SJSURoboticsTeam/URC-Mechanical-2023/ESPCAM/BP-70A BATTERY.step

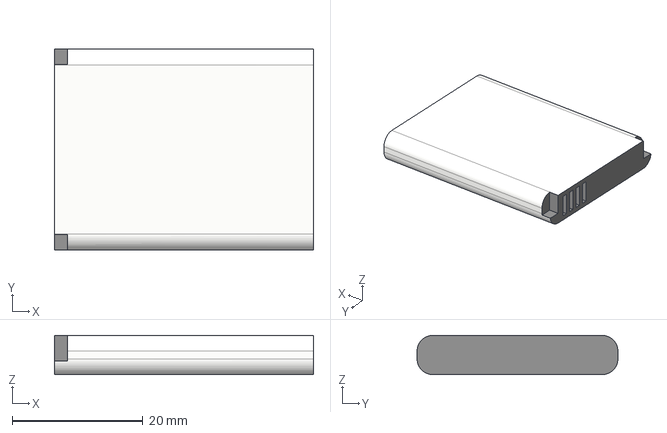
[picture p1: CAD file, 2023-09-21]
ESPCAM/BP-70A BATTERY.step
39.6 x 30.7 x 5.99 mm
