SJSURoboticsTeam/URC-Mechanical-2023/ESPCAM/CONN-SMD_BC-12-4P.step

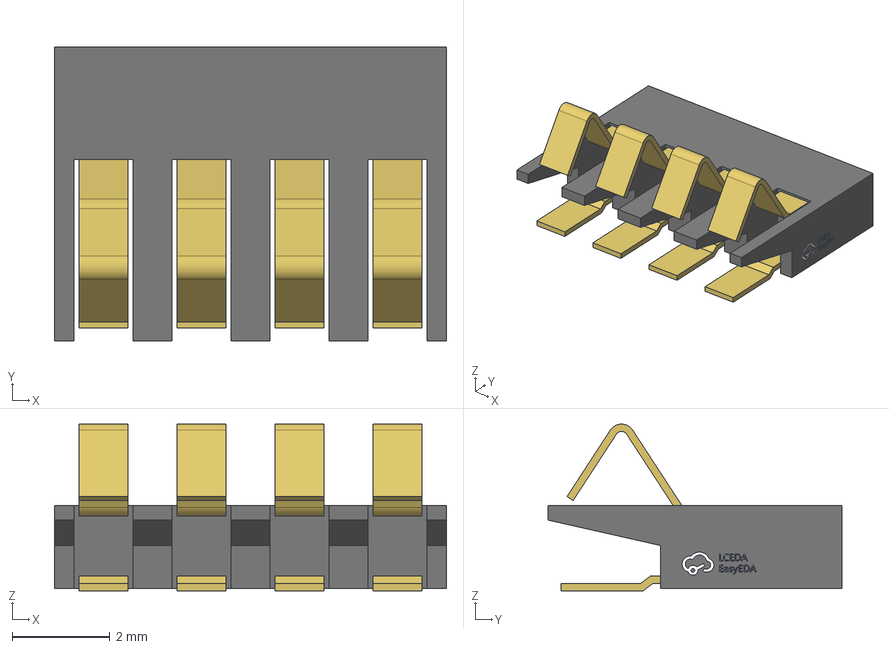
[picture p2: CAD file, 2023-09-21]
ESPCAM/CONN-SMD_BC-12-4P.step
8.00 x 6.00 x 3.40 mm
