SJSURoboticsTeam/URC-Mechanical-2023/ESPCAM/ESPCAM ASSEMBLY.pdf

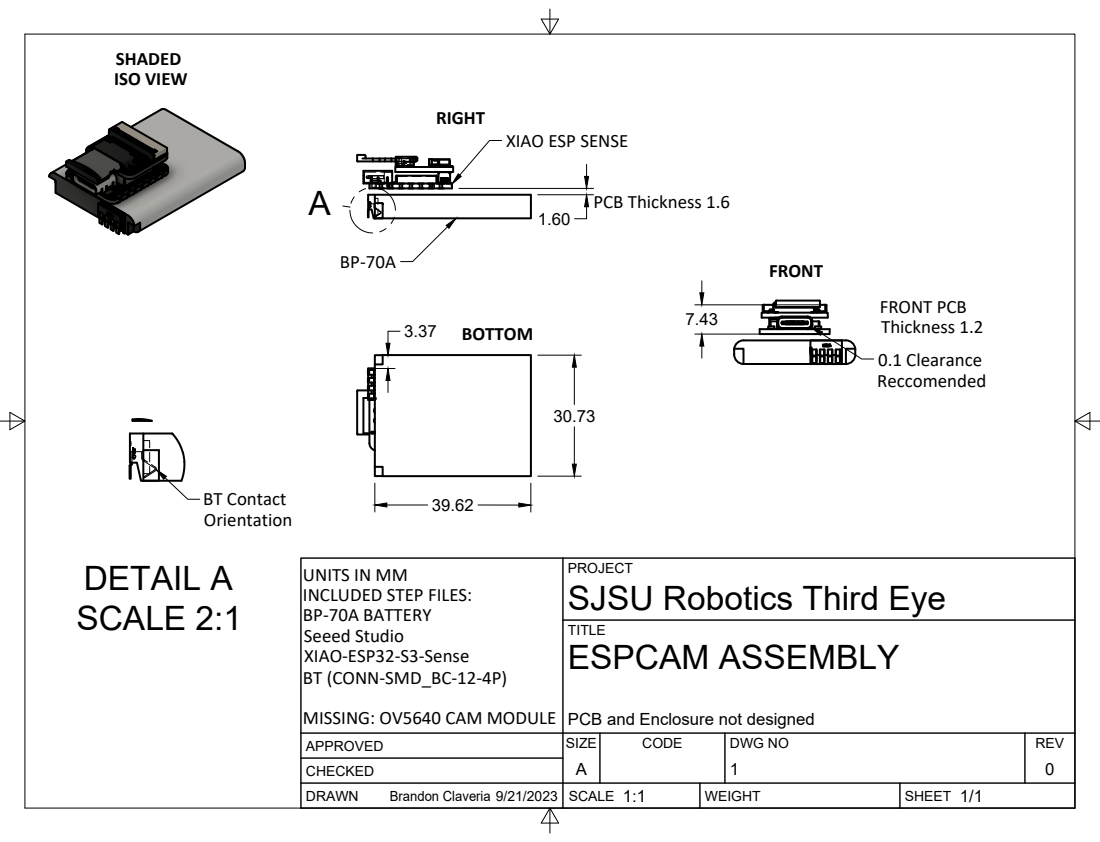
[picture p3: page 1]
SIZE; CODE; DWG NO; REV; Brandon Claveria 9/21/2023; PCB Thickness 1.6; DETAIL A SCALE 2:1; BT Contact; FRONT PCB Thickness 1.2; 0.1 Clearance; ISO VIEW

XIAO ESP SENSE

UNITS IN MM
INCLUDED STEP FILES:
BP-70A BATTERY
Seeed Studio
XIAO-ESP32-S3-Sense
BT (CONN-SMD_BC-12-4P)

PROJECT
SJSU Robotics Third Eye
ESPCAM ASSEMBLY

MISSING: OV5640 CAM MODULE

PCB and Enclosure not designed
