SJSURoboticsTeam/URC-Mechanical-2023/(threads)

Thread 1 (2022-11-20):

Fix Thin Walls

theblueone111, 2022-11-20:
Cad has thin walls from extrusion cuts. walls should be at least 1.5mm thick

Thread 2 (2022-11-20):

Shoulder Belt Tensioner

theblueone111, 2022-11-20:
The shoulder motor needs a belt tension implemented in Design

theblueone111, 2023-01-17:
Moved away from using a tension in favor of a larger pulley and new belt spacing

Closed 2023-01-17.

Thread 10 (2022-11-21):

Redesign Rotunda

theblueone111, 2022-11-21:
The rotunda no longer supports the mass thus needs a redesign. it will now only support arm electronics and battery and potentially a camera.

theblueone111, 2023-01-17:
there will be sort of a "backpack" that houses the universal board a camera, and the radio equipment

Closed 2023-04-20.

Thread 11 (2022-11-21):

Weight Robot

theblueone111, 2022-11-21:
the robot needs to be re-weighed to get new springs. after adding the arm and switching to the metal rotunda the robot is sitting a a lot lower, which is good but unexpected.

Closed 2023-01-17.

Thread 5 (2022-11-21):

Import All Pullies

theblueone111, 2022-11-21:
All pullies need to be imported from Solidworks into Onshape. This includes the arm and wheel pullies. Please import them into A Cad import folder within their respective Folder, AKA wheel pullies go in CAD imprt folder within Susp. folder.

Closed 2023-01-17.

Thread 6 (2022-11-21):

Design Slip ring assembly in Onshape

theblueone111, 2022-11-21:
the Slip ring assembly needs to be designed in onshape in the Steering Assembly PartSstudio

theblueone111, 2023-01-17:
i updated the onshape to sorta represent the real thing but we need to look it over all together to make sure its correct

Closed 2023-02-07.

Thread 7 (2022-11-21):

Design Battery Mount

theblueone111, 2022-11-21:
The mount for the ryobi 40v batteries needs to be designed, prototyped, manufactured, and tested

theblueone111, 2023-01-13:
make the battery retionion .5mm looser all around

theblueone111, 2023-01-18:
make sure the battery is removable and not not hit the suspension mount during removal

MayaEnriquez, 2023-01-24:
rotunda drive and arm battery mount have their own flat and angled versions now, drive battery clearance issue should be fixed, arm battery needs to be changed with comm tower

MayaEnriquez, 2023-02-02:
Angled mount has heat insert slots and Velcro channel, flat mount is not changed yet.

theblueone111, 2023-02-17:
purchased battery holder from amazon to expedite process as well due to lack of connector supplier

theblueone111, 2023-02-17:
battery mounts arriving feb 22 - 24

Closed 2023-07-04.

Thread 8 (2022-11-21):

Design Main Power Distribution Dorito Case

theblueone111, 2022-11-21:
The main Dorito PCB needs a case to be designed around it with 3D printing and PLA

theblueone111, 2023-01-11:
need to get updated model of the pcb as the one we currently used does not have the other two motor out connectors

theblueone111, 2023-01-12:
need tp update lid design to accommodate the usb out headers

MayaEnriquez, 2023-01-28:
waiting on new dorito design

MayaEnriquez, 2023-02-04:
new dorito design recieved, model made, not printed

MayaEnriquez, 2023-02-09:
printed

MayaEnriquez, 2023-02-25:
edits made for convenience, waiting on mounting schematic/plan to make mounting holes to be locked into place

MayaEnriquez, 2023-03-14:
Waiting on feedback/ Dorito changes were mentioned.

MayaEnriquez, 2023-04-20:
new dorito again

MayaEnriquez, 2023-07-04:
mounted to chassis bottom

Closed 2023-07-04.

Thread 15 (2023-01-09):

New motors all plates

theblueone111, 2023-01-09:
the new motor needs to be incorporated in the cad so that we can manufacture them asap

theblueone111, 2023-01-17:
new motors have been incorporated except for the rotunda

Closed 2023-01-24.

Thread 16 (2023-01-09):

Redesign arm

theblueone111, 2023-01-09:
arm needs to be way stiffer, including standoff/spacer mounts or full redesign

theblueone111, 2023-01-31:
updated outer links, need to update the lightening pattern and add hole pattern on mid links

theblueone111, 2023-03-14:
need to print all the arm plate spacers

MayaEnriquez, 2023-04-25:
Current To Do:
spacers /3d printed u channel? bearing sizes + belt tensioning

MayaEnriquez, 2023-05-07:
Currently Assembled for testing, future revision needs arm PCBs (hand Board + Bread-board + arm breakouts(3)) to have cases + wire management

PugslyFTW, 2023-10-09:
currently working on shrouds for pcbs to protect the pcbs from dust

Closed 2023-10-09.

Thread 17 (2023-01-09):

new motor backpacks

theblueone111, 2023-01-09:
the RMD X6 v2 S2 will have a pcb back pack to allow for USB -c interface. these pcbs need a spacer/enclosure designed to attach them to the tops of the motors

cdanderson4, 2023-02-03:
Motor backpacks completed, 4.8mm deep , 5.23mm diameter holes for m3 heated inserts. Brushes need to be ordered to glue in for dust prevention. Brushes: https://www.mcmaster.com/catalog/129/1551/7900T807

cdanderson4, 2023-02-03:
Still needs to be printed

MayaEnriquez, 2023-06-03:
Needs Redesign

Thread 18 (2023-01-09):

electronic Models

theblueone111, 2023-01-09:
all the electronics need to be modeled such that they can be arranged in the chassis

MayaEnriquez, 2023-01-24:
notes on what needs modeling:
Science: verify science dosing pump/vacuum pump
Comms Tower(Mission Control Bin):
Battery/mount
Transciever(Rocket 900?)
PoE connection
Access Point( after verification with mission control)
Comm Tower Case/ Wiring Setup

Closed 2023-01-18.

Thread 19 (2023-01-10):

Fix Steering assembly CAD

theblueone111, 2023-01-10:
the steering assembly part studio and assembly dont matc. the gap between the top and bottom plates are not the same from oen to the other

theblueone111, 2023-01-31:
the bottom steering plate needs to have its motor mounting holes fixed for the new s2 motors

theblueone111, 2023-01-31:
the belt spacing for the drive motors needs to be fixed to allow for the new 30T pulleys

Closed 2023-04-11.

Thread 20 (2023-01-17):

Manufacture all new plates for new motors and redesigns

theblueone111, 2023-01-17:
need to manufacture all the new plates

theblueone111, 2023-01-17:
new plates cant be made until all design changes are confirmed

theblueone111, 2023-01-17:
arm is gunna be nade to work with new motors for this version but still be redesigned for after the video

theblueone111, 2023-02-01:
all parts sent to ISM. waiting on response

theblueone111, 2023-02-03:
Talked with ims manager and he received the parts. the last set were waterjet and i asked that they laser cut this set for better cut quality.

theblueone111, 2023-02-17:
1/8th arm plates arriving feb 18th everything else arriving feb 21-25

Closed 2023-03-14.

Thread 21 (2023-01-18):

Communications Backpack

theblueone111, 2023-01-18:
A coms "backpack" needs to be designed to houseall the radio equipment and the universal board for the arm. it must be elevated above the arm battery and be an enclosure

MayaEnriquez, 2023-01-24:
First Steps
Cad:
Battery/mount
Transciever(Rocket 900?)
PoE connection
Access Point( after verification with mission control)
Comm Tower Case/ Wiring Setup

MayaEnriquez, 2023-02-02:
Cad done on existing components, waiting on info if we will need new ordered parts, workable platform area marked in a cad file.

MayaEnriquez, 2023-03-14:
Cad updated to reflect new notes: 2voltage regulators(wait on electrical), battery, r900, trendnet, kmetech Poe,

MayaEnriquez, 2023-03-23:
3/23 update/to do/issues:
**rotunda**
Are we allowed to cover handle since comm tower screws on rotunda after?
Add comm tower mounting holes to arm and autonomy rotunda plates
Double check allowable overhang and arm clearance (real sits lower than cad)
Would mounting screws for items on comm tower also need to go through rotunda/ mounting plans

**autonomy specific**
LiDAR and camera FOV blocked by comm tower?
Two power supplies or not/extra voltage regulator needed?

**electrical**
Voltage regulator 12 v & 24 v, heat dissipation how?
Custom length cables/management?

**other**
Material of comm tower:
Metal + 3D printed?
Will Utah heat be an issue

kammce, 2023-03-24:
> Voltage regulator 12 v & 24 v, heat dissipation how?

It is unlikely that the voltage regulators will need any assistance in terms of heat dissipation. But if you choose to put it in a 3D printed plastic box without air holes in order to make it dust and water resistant, then there could be some issues with heat dissipation. But the current consumption of the M9 Rocket and the AP should be quite low.

MayaEnriquez, 2023-04-20:
trendnet is replaceable with tplink as tested by Gene, 2 versions of the comm tower, notes for second version are mixed in the Autonomy Setup Github notes

MayaEnriquez, 2023-04-25:
buck ready, permission to drill holes in plates for prototype.

MayaEnriquez, 2023-04-25:
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
R900 Mount leaning 20 degrees leaning back to avoid the arm, if interference continues with the arm, 45 degrees is the next test.

Power Buck ordered.

MayaEnriquez, 2023-05-04:
Tp Link Mount is roughly designed, the prototype has all the hardware, just waiting on the electrical. Second set still being looked into & wire management is not finalized. Currently no longer requires zip-ties, just 1 velcro.

MayaEnriquez, 2023-05-11:
Manufacturing Concepts:
1. Sheet Metal + risers(space for screws)
Strong in theory, sharp in practice
2. 3D Printed
Could work with ribbing + support, heat inserts & screws?
3. Cut acrylic/plastic sheet
Most accurate hole pattern? Also, heat inserts? Not clear
4. Holes Directly into the other rotunda plate
Screw heads would need to be countersunk properly and go up to avoid hitting I think. Con is the long manufacturing time.

MayaEnriquez, 2023-06-03:
camera mount on the pvc pipe that the r900 leans on, make it super long?

Thread 22 (2023-01-24):

Science Robot CAD NTD

theblueone111, 2023-01-24:
The CAD needs to be fully fleshed out.

tommytn54, 2023-02-11:
I Need to make funnel
Science PCB case

theblueone111, 2023-02-17:
magnets need to be designed into the revolver. the hall effects need to be located in the enclosure for the revolver positioning. all components need to be mounted to the enclosure and located

MayaEnriquez, 2023-02-25:
printed  latest version for SAR video, future reccomendation: science pcb not on the bottom of the case

MayaEnriquez, 2023-05-07:
magnets in gear, gear remesh, pcb reinstall, & pump install

MayaEnriquez, 2023-05-07:
gas sensor install into gas chamber? + remodel for pressure sensor https://www.sparkfun.com/products/19096

MayaEnriquez, 2023-05-09:
holes n zipties for pump on top

Closed 2023-10-14.

Thread 23 (2023-02-04):

Initial Science Robot Super Station Plunger CAD

kate-oxley, 2023-02-04:
The CAD for the super station's plunger mechanism needs to be completed

- [x] finalize the cam dimensions
- [x] create platform to push vial up
- [x] create the cam and related parts in onshape
- [x] review & begin redesign if needed

Closed 2023-02-07.

Thread 24 (2023-02-07):

Science Robot Final Plunger CAD

kate-oxley, 2023-02-07:
- [x] Redesign cam from pear shape to disk
- [x] Change cam follower from flat faced to roller
- [x] Design a way for the roller to attach (3D printed? bearing?)
- [x] Alter cam follower shaft to fit new parameters
- [x] Change mount from horizontal to vertical & merge pieced
- [x] Design top plate to be removable
- [x] Make plunger attach to super station
- [x] Create ~60mm tall housing for plunger module
- [x] Test print
- [x] Attach springs physically
- [x] Fine tune 3D printed attachments
- [x] Reprint

kate-oxley, 2023-02-22:
For 2/21 redesign:
- [ ] switch from roller to flat faced follower (design + CAD)
- [ ] adjust tolerances
- [ ] redesign to be shorter
- [ ] re-organize feature tree
- [ ] change cam follower --> top plate attachment from press fit to a snap joint
- [ ] move the main housing sketch plane closer to the cam
- [ ] Add housing to fully surround mechanism
- [ ] Double check tolerances & joints
- [ ] Print

kate-oxley, 2023-02-22:
Note: I'm worried that the spring will be compressed too far when the mechanism is fully extended, so keep an eye on that during assembly. If it is, lengthen the space between attachment extrusions & reprint housing + follower

Closed 2023-10-14.

Thread 26 (2023-02-08):

hall effect mounts for drive

theblueone111, 2023-02-08:
need to deisgn and print hall effect mounts for a magnet and the module to replace the reed switches

theblueone111, 2023-02-09:
need to be printed and installed

Closed 2023-04-11.

Thread 31 (2023-03-14):

build new steering module

theblueone111, 2023-03-14:
one new module needs to be assembled and tested before upgrading the remaining two modules

theblueone111, 2023-03-14:
new slip ring assembly needs to be printed

Closed 2023-06-03.

Thread 33 (2023-03-14):

science modules iteration

theblueone111, 2023-03-14:
need to change the revolver to direct drive by the 360deg servo. need to make dosing pump setuup work. need to make mounts for liquid tanks. need to make mounting solution for vacuum pump. need to make mount in gas chamber for co2 and mq2 sensors.

Closed 2023-10-14.

Thread 34 (2023-03-15):

Autonomy Mount

MayaEnriquez, 2023-03-15:
List to be put in Cad: Autonomy Components
Antennae + red antennae module(Needs Case Also)
IMU(Needs Case Also)
Oak D Pro Wide ( maybe Camera gimble???)
Battery Bank
Raspberry Pi(Has a Case, case has no good mounting points)
RPLIDAR
Notes: Wires for antennae seem delicate
Must fit on a rotunda with the comm tower parts but the drill battery for arm isn't needed

MayaEnriquez, 2023-03-15:
Notes from discord:
Compass Placement - Needs to be away from all electronics

GPS Placement - Better if it were away from other electronics and as high as possible

Raspberry Pi - Anywhere near the Dorito is fine as long as we have wires that can reach all the devices

Camera Placement - Needs to be in the front or middle of the rover. Also needs stability for proper sensing. (Maybe get gimbal for later?)

External Battery - Can be placed anywhere on the rover but should not be free to move.

Beacon LED - Autonomy requires an RGB LED that can be seen in bright daylight. I have been talking to Brandon about this but I don't think we've found anything yet.

acarrou, 2023-03-15:
## USB Ports we use for Autonomous Systems:
### For the RPI
- Camera | (USB A => USB C)
- GPS | (USB A => USB C)
- Lidar | (USB A => Micro USB)
- LPC | (USB A => USB C)
### USB Ports for the Power System
- camera power | (USB A => USB C)
- lidar power | (USB A => Barrel Connector)
## I2C and Power:
- IMU | data: (SCL, SDA => SCL, SDA) | power: (5V, GND)

MayaEnriquez, 2023-03-28:
Cad as of 3/28: other than antenna module, other physical components are in cad, tower needs to be made

MayaEnriquez, 2023-03-29:
Small hold(comm tower design needs to be sorted to get new available footprint)

kate-oxley, 2023-04-08:
### Stuff on top of rotunda
#### Autonomy
- RPLidar  (must have at LEAST 180° unblocked field of vision, meaning nothing can go above horizontal line in CAD)
- Raspberry Pi
- IMU (must be centered, y to front (ask Adrien which one's front))
- Cam + gimbal (gimbal needs to be bought or designed)
- Antenna + antenna module
#### Comm Tower
- Drill battery
- Power buck
- R900
- Trendnet

### Design Notes
- Place camera/gimbal towards front
- IMU, antenna module, and power buck need cases
- antenna needs to be high (Q: how high? A: high)
- Raspberry pi has ports on almost every end, meaning it can't be blocked, will eventually need wiring clips or something, and needs to connect to things on different parts of robot (nothing moving)

- [ ] Design/buy camera gimbal (or make someone else do it, Nate or Adrien or Gene)
- [ ]  Design cases for IMU, antenna module, and power buck

kammce, 2023-04-09:
Camera Gimbal selection can be a joint thing. Meaning, it might be good for different parties to look into what type of gimbal would work and then come together to discuss which one fits the needs best. Or mechanical can simply manage this since they have information on the size and constraints of the camera intelsys is using.

Thread 35 (2023-03-15):

Bread PCB Case(Toaster)

MayaEnriquez, 2023-03-15:

MayaEnriquez, 2023-03-15:
Case for Bread PCB mountable to new arm design

MayaEnriquez, 2023-06-24:
URC 2023 > 2023 Robot > Arm > Imports > arm breakout

BadOpi, 2023-07-11:
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

BadOpi, 2023-07-11:
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

Bread Board and arm breakout mounted directly onto arm

BadOpi, 2023-07-11:
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

Rotunda breakout and Buck board mount prototype needs to be printed and mounted

thejonathanouyang, 2023-07-21:
Bread PCB successfully mounted to arm w/o case. Toaster Mount no longer required.

BadOpi, 2023-07-29:
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

Breakout and Buck Board updated mount for clearance of leg mounts

Thread 37 (2023-04-04):

Autonomy Camera Ginbal

MayaEnriquez, 2023-04-04:
adapt an old one or look into buying/making a new one.

MayaEnriquez, 2023-05-06:
camera- https://shop.luxonis.com/products/oak-d-pro-w

MayaEnriquez, 2023-05-06:
Note For Custom Connection:
If you try to make a DIY camera mount you need to make sure you use the correct type of screw thread. There are two camera tripod screw thread sizes, 1/4-20 UNC and 3/8-16 UNC, part of the Unified Thread Standard (UTS). The ¼-inch screw size is for most cameras and some lenses, while the 3/8-inch screw is for larger professional cameras.

Thread 38 (2023-04-20):

mimic

MayaEnriquez, 2023-04-20:

MayaEnriquez, 2023-04-20:
Most Recent Issues: Add Rubber Washers to tension

MayaEnriquez, 2023-05-06:
waiting on driver/ feedback for new mech draft

Thread 40 (2023-04-25):

Club Equipment

MayaEnriquez, 2023-04-25:
We have a drill press, dremel, saw, and 3d printers for basic prototyping. These are not great for final installs.

We want a waterjet or a CNC router.
- Email Viswanathan- Permission to install, or reliable access to a machine shop(unlikely)
- Email FD&O? - Also permission to install

mattheward, 2023-05-04:
Hello

Thread 42 (2023-05-02):

Purchase Ryobi Battery Mount

MayaEnriquez, 2023-05-02:
Buy batttery mount ( bc we could not buy prongs for our version)

MayaEnriquez, 2023-05-02:
i think this is the link
https://www.amazon.com/Adapter-Lithium-ion-Battery-Connector-Robotics/dp/B07J17Z42R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

MayaEnriquez, 2023-05-02:
@swiftrax

swiftrax, 2023-05-02:
purchased

Closed 2023-06-03.

Thread 44 (2023-06-13):

End Effector(Claw)

MayaEnriquez, 2023-06-13:
Kate researched claws.
Stuff that needs to go on it: Claw, Motor, Hand Pcb(Check Slip Ring vs USB C cable), Laser pointer, whatever gears/mechanism.
The current design needs to be extended or redone to make more space.
The expected Degree of freedom(Pitch & Yaw range) needs to be discussed/ changed based on how the hand PCB is cabled.
This should be changed/finished on the 2023 rover, ideally before we start on the 2024 version so we can see what to change in the future.

kate-oxley, 2023-06-13:
:)

MayaEnriquez, 2023-06-13:
Laser pointer : https://a.co/d/f2Ml6A3

kate-oxley, 2023-07-08:
### Current Issues
**Servo horn doesn’t fit because it was 3d printed**
Fix: buy one that fits
**Joints are loose**
Fix: redesign claw joints to use bushings/shoulder bolts/bearings/something that screws into something other than plastic
**Add room for accelerometer**
Note: uses usb-c cable (can’t use a slip ring)

kate-oxley, 2023-07-08:
### Hardware List (in progress)
28mm shoulder screw x4
35mm shoulder screw x2
Servo horn for FeeTech digital servo
Gear to fit servo horn & partial gears
Partial gear x2

kate-oxley, 2023-07-08:
### Just kidding now this
- add printed bushings in place of shoulder screws
- do the math
- thicken gears

kate-oxley, 2023-07-18:
# 7/15 Update
Printed & tested a laser cut/3D printed prototype
## Changes from the previous design
- Top upper links moved under the top plate to prevent interference with gears
- Doesn't use threading to keep bolts in place to allow for movement
- Clearance holes widened for moving joints
## Conclusions
#### Pros
- Actually moves
- Fully opens and closes
#### Cons
- Still relies on clamping to keep joints in place
- Gear ratio not ideal (requires too much torque)
- Doesn't have room for all of the electronics
## Changes to make
- Make gears thicker
- Decrease gear ratio
- add mounting holes for PCB board
- add space for laser diode
- Slip ring?

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

kammce, 2023-07-18:
Note that the accelerometer can be place on the wrist. Or if the differential wrist is used, you can put it on the feedback gear. The feedback gear is the gear on the back that looks like it doesn't do anything. The complexity of this design is that it needs a slip ring. Another option is what we did for the Rover Nessie (2nd rover) which was a board with a magnetic encoder (roll feedback) and accelerometer (pitch feedback) with a magnet on the feedback gear that can spin freely.

@kate-oxley

kate-oxley, 2023-07-19:
@kammce got it, that's very good to know. If the accelerometer's mounted on the feedback wrist, would the only wires that need to go through the slip ring be for the laser and servo? Or am I missing any components?

kate-oxley, 2024-03-29:
I'm updating the 2024 end effector issue's opening comment to better reflect the new rules, so I'm putting the 2023 one here.

## Description
The end effector is a 4 bar claw mechanism that will move small items (e.g. wrenches, hammers, etc.), transport rocks (>5 kg), and maneuver small items (e.g. type on a keyboard, tighten an allen wrench, flip switches, etc.).

## Goals/Constraints
The most relevant sections of the [rules](https://drive.google.com/file/d/1LY5VX9Psww8Bx4ub_AWMgUlajPZQ2X2A/view?usp=sharing) are as follows:
> **1.c.iii.** Objects to be retrieved in the field will consist of small lightweight hand tools (e.g.
screwdriver, hammer, wrench), small instruments (actual or simulated, e.g. a small
box), supply containers (e.g. toolbox, gasoline can), or rocks up to 5 kg in mass. All
items except the rocks will have graspable features (such as a handle) no greater than
5 cm in diameter. The maximum dimensions shall be no larger than 40 cm x 40 cm x
40 cm, but teams should expect a variety of sizes and weights.

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

To summarize, the end effector will interact with the following:
- Hand tools (e.g. screwdriver, hammer, wrench)
- Small instruments (e.g. a small box)
- Supply containers (e.g. toolbox, gasoline can)
- Rocks (<5 kg)
- Cache container (<10cm long, <5cm diameter)
- Drawer handle
- 5/16” allen wrench (must perform multiple rotations)
- A latch (which it will have to undo to open a hinged panel)
- Keyboard (will have to interact with individual keys without hitting the ones next to it)
- Joystick (4-position with spring return. Will require some level of precision
- USB memory stick (will be picked up and plugged in)
- Buttons
- Flip switches
- Door knobs (must be grasped and turned in place)

These are from the 2023 manual, but the guidelines shouldn't change much next year. This section will be updated when next year's manual is released

## Additional Contacts
@starphys (mission controls)
@klam20 (electronics)

## Electronics
[Raspberry Pi Zero](https://www.raspberrypi.com/products/raspberry-pi-zero-w/)
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
[PCB Board](https://cad.onshape.com/documents/b97908e17fca3929ddd39b66/w/d2da11b1b8072d5890f9997f/e/9e338429d6229ba6767c538d)
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
[Raspberry Pi Camera Board v1.3](https://uk.pi-supply.com/products/raspberry-pi-camera-board-v1-3-5mp-1080p)
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
[Servo](https://www.amazon.com/FEETECH-Voltage-Waterproof-Digital-Aluminium/dp/B097DKQFGM?th=1)
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
[Laser Diode](https://www.amazon.com/dp/B07PMJ61K3?_encoding=UTF8&ref_=cm_sw_r_cp_ud_dp_YS9MR5RZ0YQ1AVF2D850&th=1)
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

## Connections
Camera module --> raspberry pi via ribbon cable
Servo --> PCB board via PWM wires
Laser diode --> PCB board via power wires
PCB board --> battery (OFF CLAW) via USB-C cable

##  CAD
Access CAD [here](https://cad.onshape.com/documents/c37df51db9b15e2c88891fad/w/a9ac27298267f2e4acc75c70/e/678b541912aa5ddd8279553e)
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

Thread 45 (2023-07-22):

Mast Cam

MayaEnriquez, 2023-07-22:
@starphys wants a camera cable slot from the bottom of the cam so that the orientation of the camera view is right side up, currently it is loosely routed over the top of the mast cam.

swiftrax, 2023-09-20:
https://grabcad.com/library/seeed-studio-xiao-esp32s3-sense-1

Thread 46 (2023-08-26):

Science Assembly

kate-oxley, 2023-08-26:
### Parts to print
- [ ] Revolver Top - Science PS
- [ ] Science mount (maybe) - Science PS
- [ ]

Notes:
- Cover for electronics board doesn't fit anymore -- add hole before reprinting
- Cam roller isn't on straight anymore

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

william-green, 2023-08-26:
We also need to order more magnets. We want to order 8mm magnets so we have extras. Some of the magnets on the revolver are the 6mm ones and they're too small to activate the hall effect sensor.

For the revolver, are the spacers supposed to be printed? If so, probably add those to the list of parts to print.

Thread 47 (2023-09-21):

ESPCAM PCB and Enclosure

swiftrax, 2023-09-21:
Design PCB Shape and Enclosure for ESPCAM Modules to replace the RaspberryPi Cameras

swiftrax, 2023-09-24:
[Page 11](https://cdn-learn.adafruit.com/assets/assets/000/118/306/original/ov5640_datasheet.pdf?1675869959)

MayaEnriquez, 2023-11-28:
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

kate-oxley, 2023-11-28:
Battery CAD: https://cad.onshape.com/documents/313e58e88414a4244f7b0d63/w/17981e2a666f6c41be5abf0a/e/39c370c3da684f6fbf8131be
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

kate-oxley, 2024-01-06:
## Components
#### 3.7V 2000mAh Lithium Ion Battery
- [Product Link](https://www.adafruit.com/product/2011#technical-details)
- [CAD Link](https://cad.onshape.com/documents/313e58e88414a4244f7b0d63/w/17981e2a666f6c41be5abf0a/e/39c370c3da684f6fbf8131be)
#### ESPCAM Module
- [Product Link](https://www.seeedstudio.com/XIAO-ESP32S3-Sense-p-5639.html)
- [CAD Link](https://cad.onshape.com/documents/313e58e88414a4244f7b0d63/w/17981e2a666f6c41be5abf0a/e/94104771afa3fdbed158cd35)
#### Horizontal PCB Board
- [CAD Link](https://cad.onshape.com/documents/313e58e88414a4244f7b0d63/w/17981e2a666f6c41be5abf0a/e/ef64b96fcec262140792109e)
####  Vertical PCB Board
- Still being designed :(

kate-oxley, 2024-01-20:
## 1/20 Update
- The battery changed! [This](https://www.adafruit.com/product/2011#technical-details) was the old one and [this](https://www.amazon.com/EEMB-2000mAh-Battery-Rechargeable-Connector/dp/B08214DJLJ?th=1) is the new one
- The second PCB board has been finalized! The CAD is [here](https://cad.onshape.com/documents/013474a69af546f3cd9901b3/w/e3fd1047fbf118b541a6adc6/e/b0767426f575ef249fca3ff9), it's slightly wider than expected but not enough to cause any problems
- The CAD location has changed from 2024 imports to its own PS in 2023 (found [here](https://cad.onshape.com/documents/013474a69af546f3cd9901b3/w/e3fd1047fbf118b541a6adc6/e/c28bd8ebf0d8418527ccdccc))
- The overall design has changed a bit. Before each part came together individually (for ease of disassembly), but the new plan is to make the front more open so the PCBs can be soldered together (see Maya's attached drawing)
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

kate-oxley, 2024-01-21:
Note: hardware is temporarily in the arm mechanical box

Thread 48 (2023-10-14):

Arm Shoulder Motor Mount Fix

thejonathanouyang, 2023-10-14:

thejonathanouyang, 2023-10-14:
BOM:
1 x Plate 1
1 x Plate 2
2 x Replaceable screw stops
6 x M4x15mm screw, socket
2 x M4x20mm screw, socket
8 x M4 washers
8 x M4 lock washers
